nickfermilu/Mind-Masters/README.md

# Mind-Masters
ECE 455 Capstone Project - Brain Stimulator
