nickfermilu/Mind-Masters/SP26_Mind-Masters_Feedback_Circuit_Diagram_Braxton_Lang.png

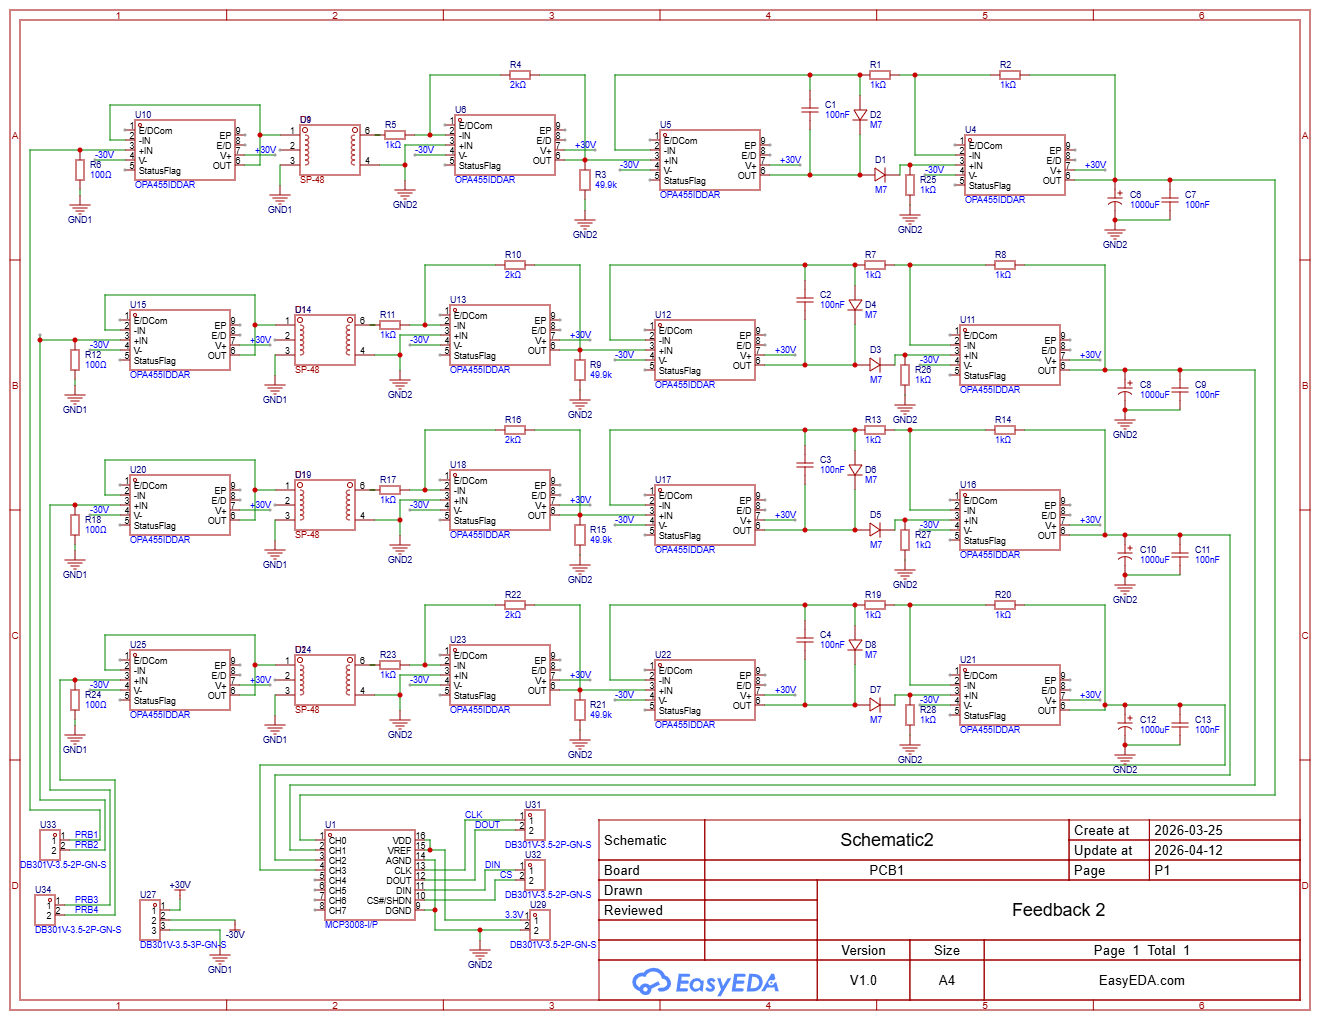
SP26_Mind-Masters_Feedback_Circuit_Diagram_Braxton_Lang.png
