nickfermilu/Mind-Masters/SP26_MindMasters_PowerBoardSchematic_NickLu.png

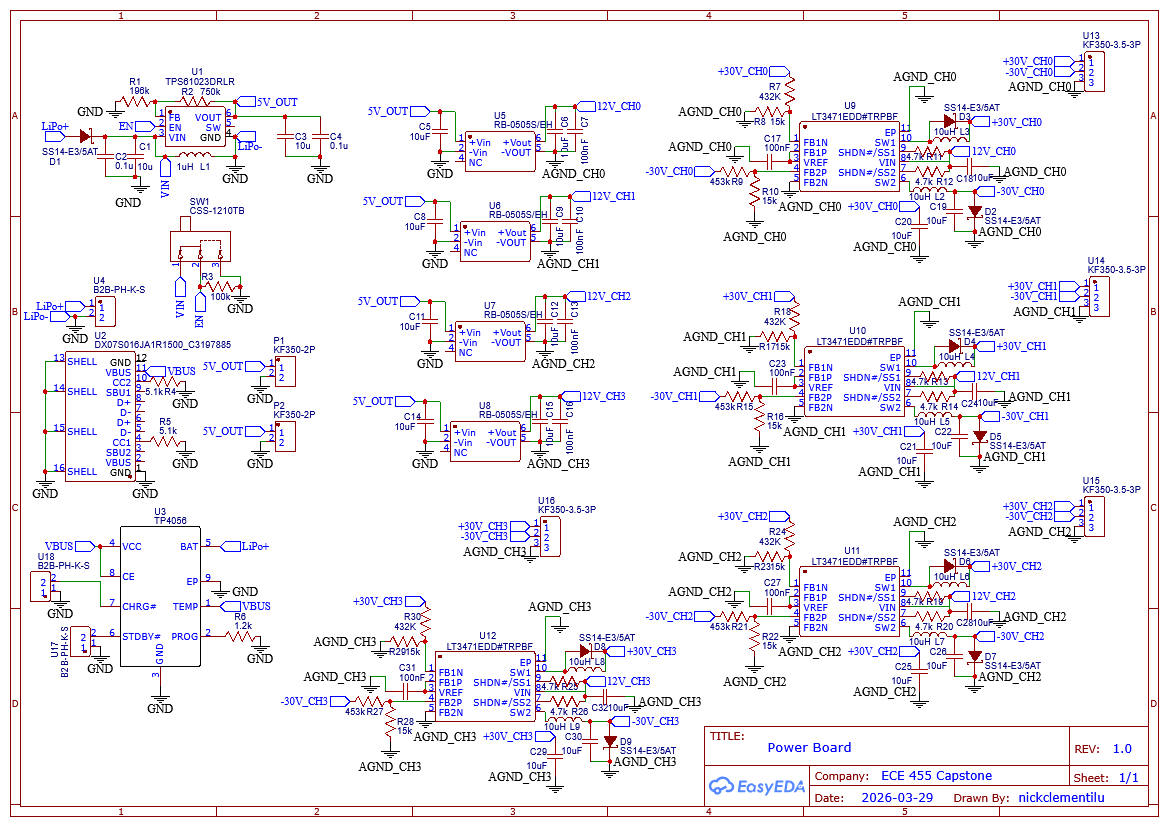
SP26_MindMasters_PowerBoardSchematic_NickLu.png
