nickfermilu/Mind-Masters/SP26_MindMasters_WaveformGenerationSchematic_NickLu.png

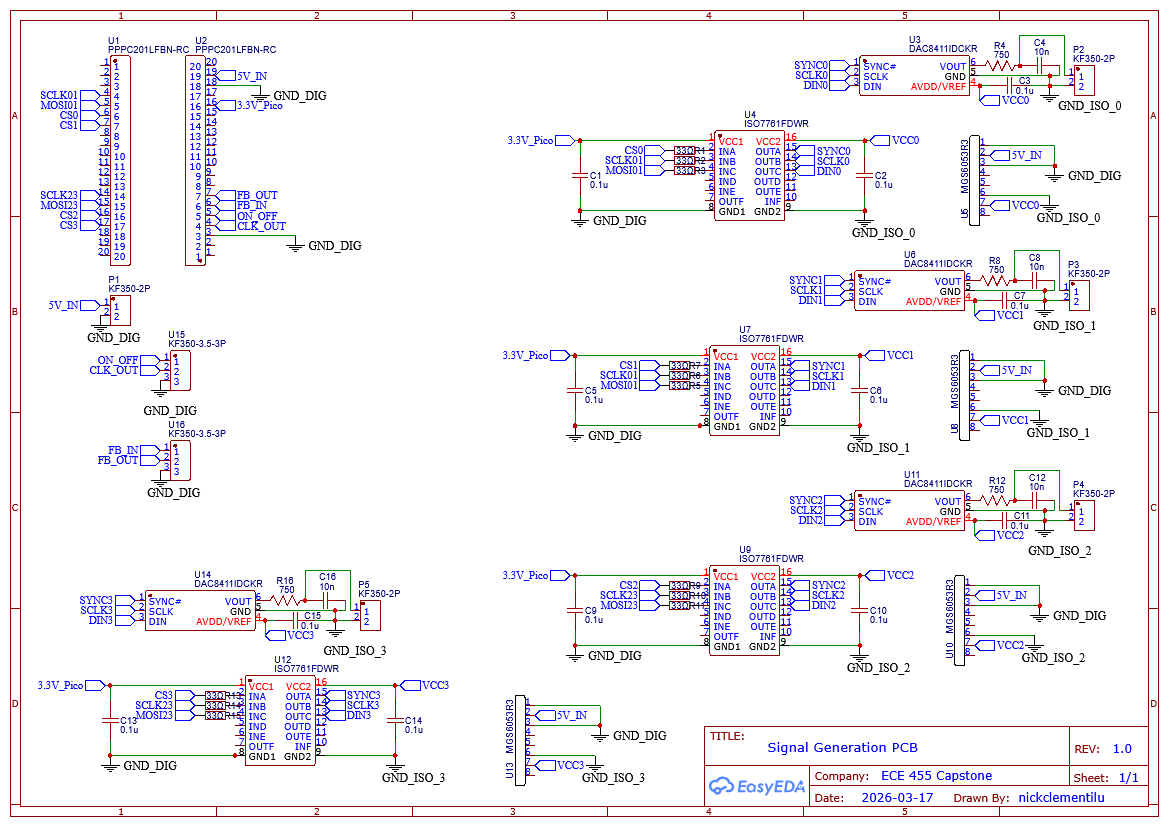
SP26_MindMasters_WaveformGenerationSchematic_NickLu.png
