nickfermilu/Mind-Masters/SP26_MindMasters_BillOfMaterials_NickLu.xlsx

Bill of Materials
Quantity | Description | Part | Category | Price | Total Spent | Link
20 | Screw In Terminal | 691137710002 | Current Amplifer | $0.38 | $6.96 | https://www.digikey.com/short/h4bqh1vj
10 | Resistor | RC1206DR-0710KL | Current Amplifer | $0.09 | $0.90 | https://www.digikey.com/short/cj3h99h8
10 | Resistor | RC1206FR-07634RL | Current Amplifer | $0.04 | $0.44 | https://www.digikey.com/short/8z23nzfm
10 | Resistor | RC1206FR-07100RL | Current Amplifer | $0.04 | $0.44 | https://www.digikey.com/short/29ft3q24
10 | Op Amp | OPA455IDDAR | Current Amplifer | $6.69 | $66.90 | https://www.digikey.com/short/r2zpp299
10 | Capacitor | CL05B104KB54PNC | Feedback | $0.39 | $0.39 | https://www.digikey.com/short/rv8q03bw
12 | Capacitor | CL10B104KB8NNNC | Feedback | $0.32 | $0.32 | https://www.digikey.com/short/pr99n85f
10 | Capacitor | CC0603KRX7R9BB103 | Feedback | $0.30 | $0.30 | https://www.digikey.com/short/327jvn84
10 | Resistor | RC0603FR-07750RL | Feedback | $0.24 | $0.24 | https://www.digikey.com/short/bptq3j8d
12 | Resistor | RC0603FR-0733RL | Feedback | $0.29 | $0.29 | https://www.digikey.com/short/p08cz4nz
4 | Capacitor | 10ZLH1000MEFC10X12.5 | Feedback | $0.51 | $2.04 | https://www.digikey.com/short/h4jvq459
16 | Resistor | RC0603FR-071KL | Feedback | $0.02 | $0.38 | https://www.digikey.com/short/2t2rhvq0
10 | Resistor | RC0603FR-0749K9L | Feedback | $0.02 | $0.24 | https://www.digikey.com/short/zh0wmth2
10 | Resistor | RC0603FR-072KL | Feedback | $0.02 | $0.24 | https://www.digikey.com/short/0hfjwmf7
10 | Resistor | RC0603FR-07100RL | Feedback | $0.02 | $0.24 | https://www.digikey.com/short/vdrw7z0f
1 | MCP | MCP3008-I/P | Feedback | $3.12 | $3.12 | https://www.digikey.com/short/5fw15d1m
16 | Op Amp | OPA455IDDAR | Feedback | $6.69 | $107.04 | https://www.digikey.com/short/pt8tj7qb
10 | Diode | M7 | Feedback | $0.07 | $0.72 | https://www.digikey.com/short/tjcvm2fp
4 | Transformer | SP-48 | Feedback | $17.75 | $71.00 | https://www.digikey.com/short/dvr8h1q8
8 | EEG Connector | 65.3300-21 | Output | $2.83 | $22.64 | https://www.tme.com/us/en-us/details/mlb1.5-r-21/2mm-banana-sockets/staubli/65-3300-21/
10 | EEG Electrode | MDYN-D48-10 | Output | $9.28 | $9.28 | https://www.saveritemedical.com/products/med-dyne-eeg-disposable-cup-electrodes?variant=40245685452886
10 | Screw In Terminal | 691214110002 | Power Generation | $1.04 | $10.36 | https://www.digikey.com/short/fdq5tqt4
4 | Screw In Terminal | 691214110003 | Power Generation | $0.62 | $6.19 | https://www.digikey.com/short/rp48hdb9
25 | Capacitor | CL21A106KAYNNNE | Power Generation | $0.10 | $2.45 | https://www.digikey.com/short/251p0d54
10 | Capacitor | CC0603KRX7R9BB104 | Power Generation | $0.04 | $0.43 | https://www.digikey.com/short/34rbfjpc
10 | Diode | SS14-E3/5AT | Power Generation | $0.18 | $1.84 | https://www.digikey.com/short/t3vn2f79
1 | Inductor | BRL3225T1R0M | Power Generation | $0.18 | $0.18 | https://www.digikey.com/short/2wmhvmqd
10 | Inductor | NRS5030T100MMGJ | Power Generation | $0.20 | $1.98 | https://www.digikey.com/short/0phn0vdz
1 | Switch | CSS-1210TB | Power Generation | $0.72 | $0.72 | https://www.digikey.com/short/jr14t4dr
1 | Charging IC | TPS61023DRLR | Power Generation | $1.12 | $1.12 | https://www.digikey.com/short/27f8v5zn
1 | USB-C Conn | DX07S016JA1R1500 | Power Generation | $2.15 | $2.15 | https://www.digikey.com/short/fj1hj9jr
3 | Header | B2B-PH-K-S | Power Generation | $0.11 | $0.33 | https://www.digikey.com/short/7hq5d353
4 | Boost Converter | LT3471EDD#TRPBF | Power Generation | $9.79 | $39.16 | https://www.digikey.com/short/www0zcv7
4 | DC DC Converter | RB-0505S | Power Generation | $6.51 | $26.04 | https://www.digikey.com/short/h7d9pmt0
1 | Charging IC | TPB4056B2X-ES1R | Power Generation | $0.50 | $0.50 | https://www.digikey.com/short/qqh5pww2
2 | Capacitor | CC0603MRX5R6BB106 | Power Generation | $0.18 | $0.36 | https://www.digikey.com/short/t2r2m115
10 | Resistor | RC0603FR-071K2L | Power Generation | $0.02 | $0.24 | https://www.digikey.com/short/8t29rbhq
10 | Resistor | RC0603FR-074K7L | Power Generation | $0.02 | $0.24 | https://www.digikey.com/short/h5t0njh5
10 | Resistor | RC0603FR-075K1L | Power Generation | $0.02 | $0.24 | https://www.digikey.com/short/c2mvb1rh
10 | Resistor | RC0603FR-0715KL | Power Generation | $0.02 | $0.24 | https://www.digikey.com/short/284tnr3t
10 | Resistor | RC0603FR-07100KL | Power Generation | $0.02 | $0.24 | https://www.digikey.com/short/qzfd5wp3
10 | Resistor | RC0603FR-07196KL | Power Generation | $0.02 | $0.24 | https://www.digikey.com/short/h9zn8245
10 | Resistor | RC0603FR-07453KL | Power Generation | $0.02 | $0.24 | https://www.digikey.com/short/5zpdhcjz
10 | Resistor | RC0603FR-07432KL | Power Generation | $0.02 | $0.24 | https://www.digikey.com/short/715fbr88
10 | Resistor | RC0603FR-07750KL | Power Generation | $0.02 | $0.24 | https://www.digikey.com/short/72mpm7fc
1 | Battery | 3.7V 2300mAh 104050 Lipo Battery | Power Generation | $10.99 | $10.99 | https://www.amazon.com/dp/B0GDQG1PXW
1 | LEDs | Panel Mount LED | Power Generation | $13.99 | $13.99 | https://www.amazon.com/dp/B0B2L89W9C
1 | Switch | SS12F15 Slide Switch | Power Generation | $4.99 | $4.99 | https://www.amazon.com/dp/B0FNRDWD4B
4 | DAC | DAC8411IDCKT | Signal Generation | $8.08 | $32.32 | https://www.digikey.com/short/pbwnvqr3
4 | SPI Isolation | ISO7761FDWR | Signal Generation | $3.67 | $14.68 | https://www.digikey.com/short/qnvhtwzt
4 | LDO Regulator | MCP1700-3302E/TO | Signal Generation | $0.50 | $2.00 | https://www.digikey.com/short/jbv518jv
1 | LDO Regulator | MCP1700-3302E/TO | Signal Generation | $0.50 | $0.50 | https://www.digikey.com/short/jbv518jv
4 | DC DC Converter | MGS6053R3 | Signal Generation | $20.71 | $82.84 | https://www.digikey.com/short/tj5ddddw
2 | Header | PPPC201LFBN-RC | Signal Generation | $1.14 | $2.28 | https://www.digikey.com/short/hfb5n4v4
2 | Screw In Terminal | 691214110003 | Signal Generation | $1.55 | $3.10 | https://www.digikey.com/short/wrd3p9hp
10 | Screw In Terminal | 691214110002 | Signal Generation | $1.04 | $10.36 | https://www.digikey.com/short/8d859f7f
