nickfermilu/Mind-Masters/(list of files, cad)

Other CAD files:
SP26_MindMasters_Enclosure_CameronVanOs.f3d
