nickfermilu/Mind-Masters/SP26_Mind_Masters_Feedback_PCB_Braxton_Lang.pdf

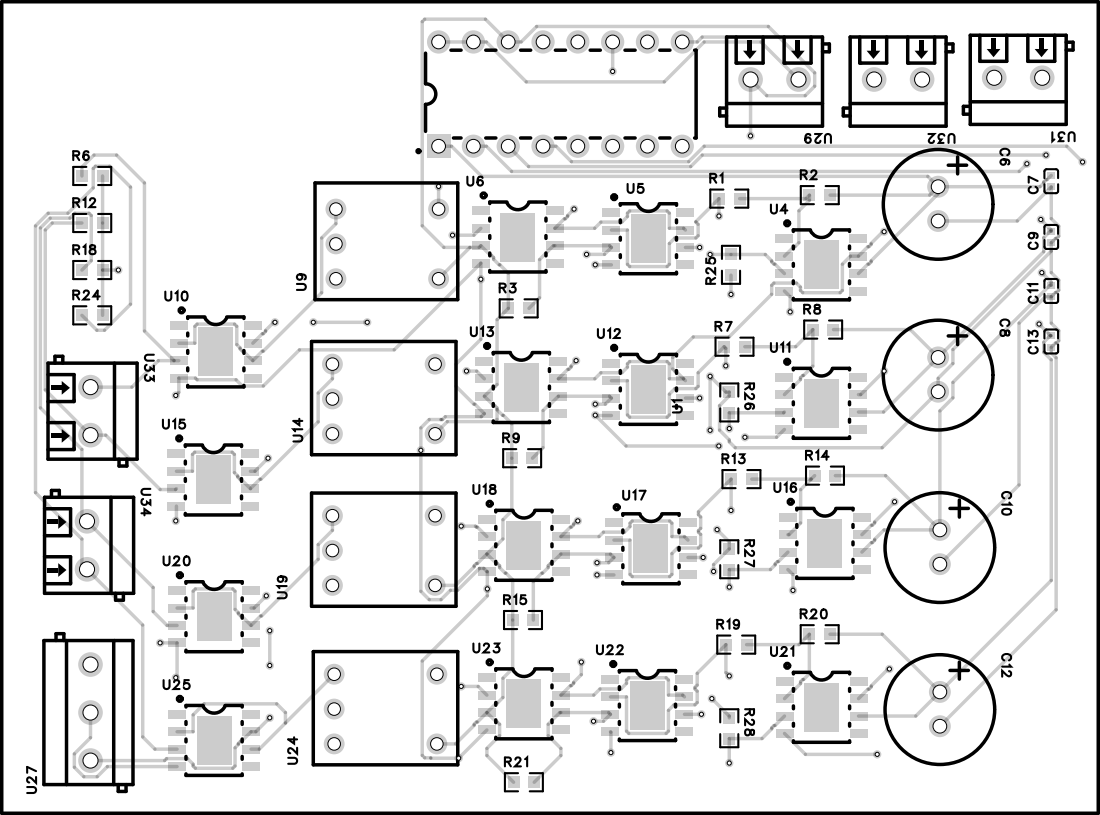
[picture p4: page 1]

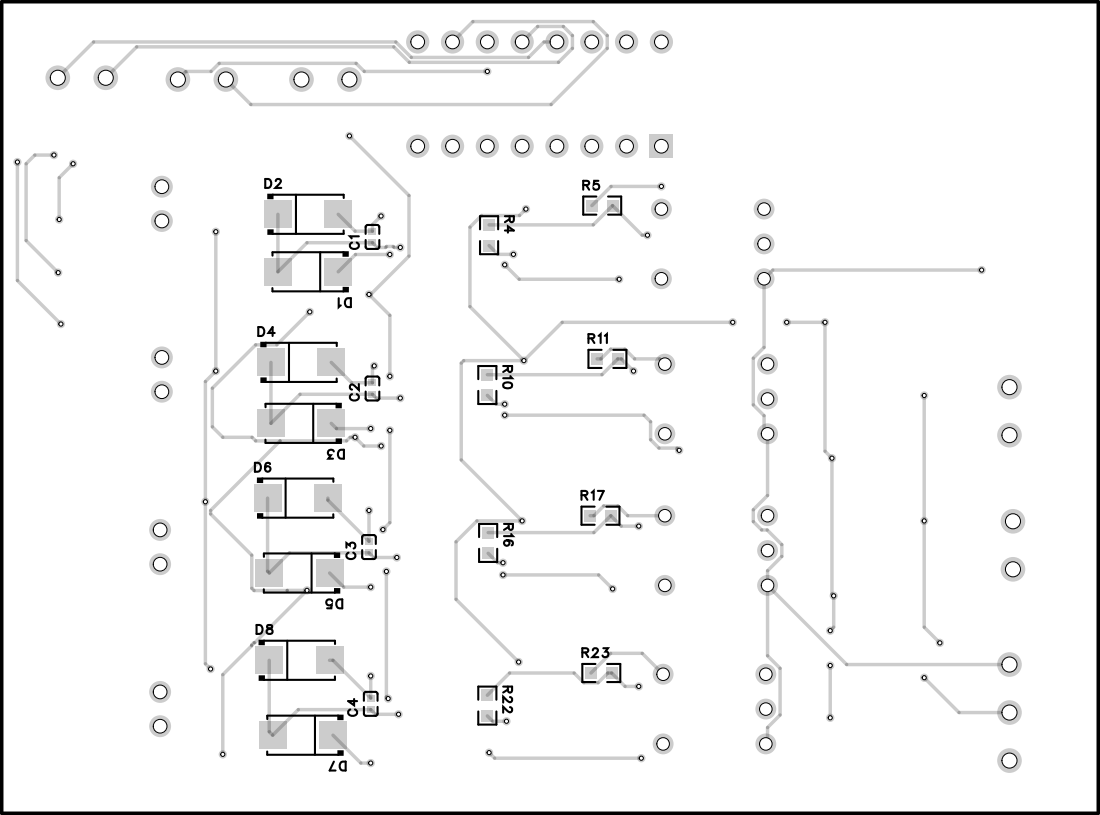
[picture p5: page 2]

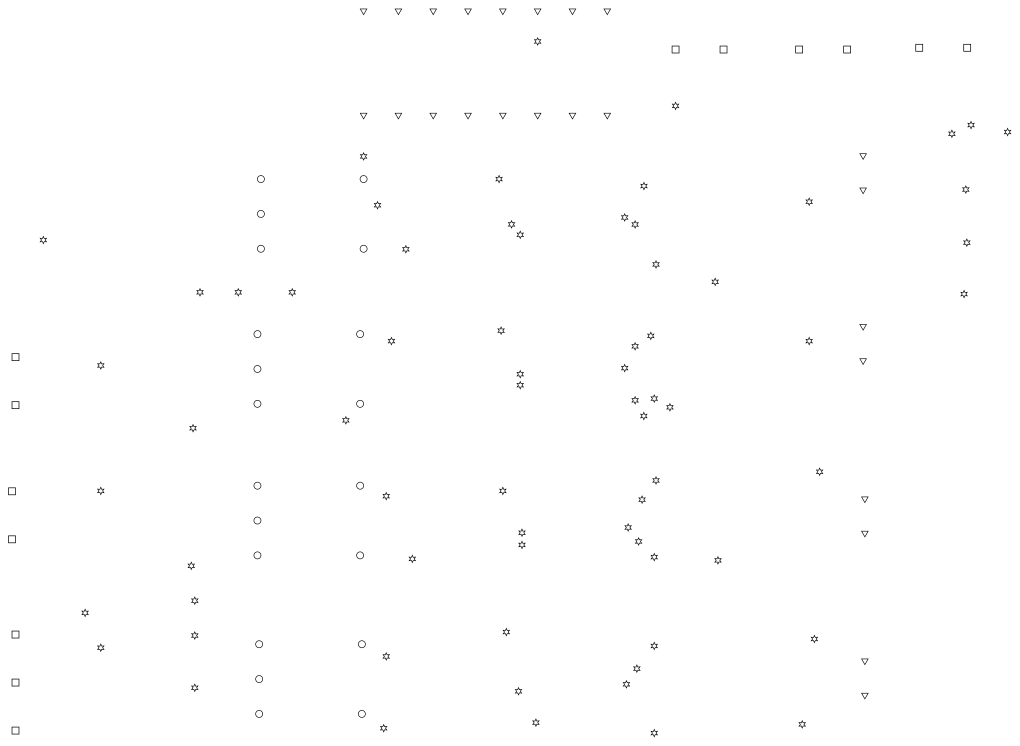
[picture p6: page 3]
