nickfermilu/Mind-Masters/SP26_MindMasters_PowerBoardPCB_NickLu.pdf

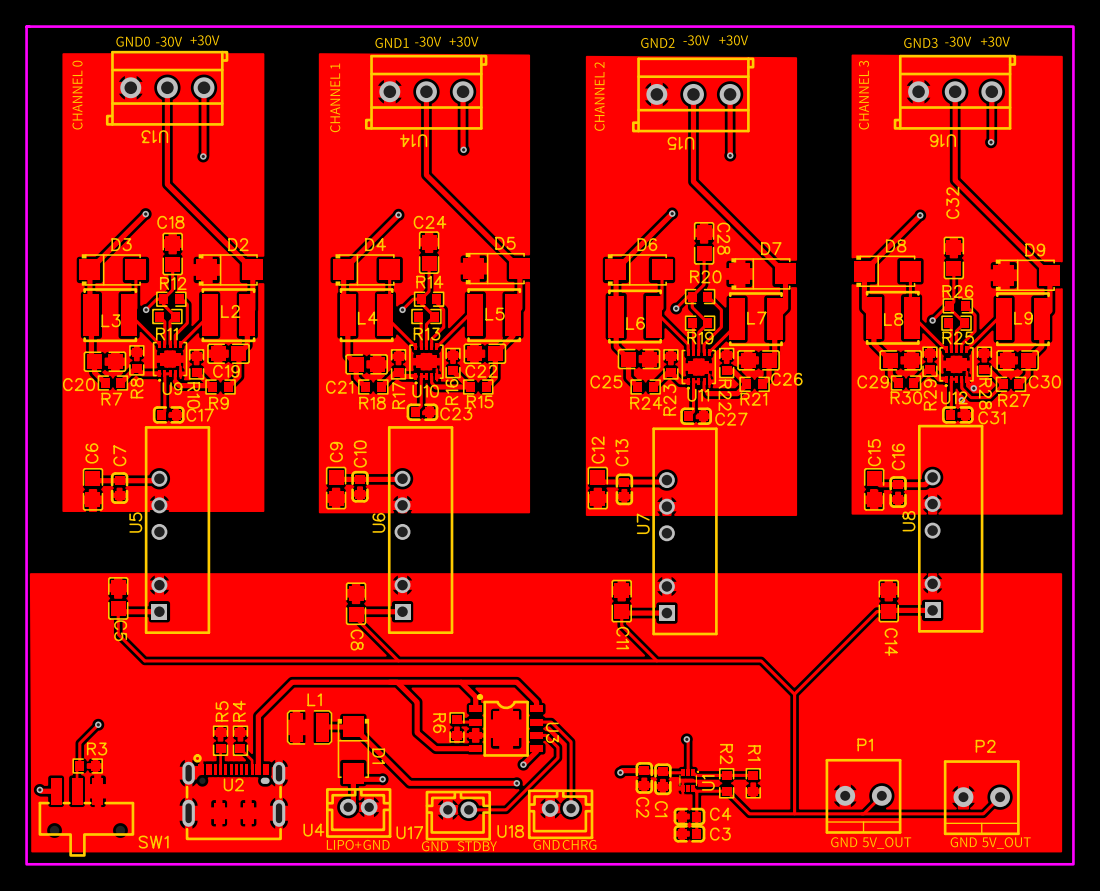
[picture p7: page 1]
