nickfermilu/Mind-Masters/SP26_MindMasters_WaveformGenerationPCB_NickLu.pdf

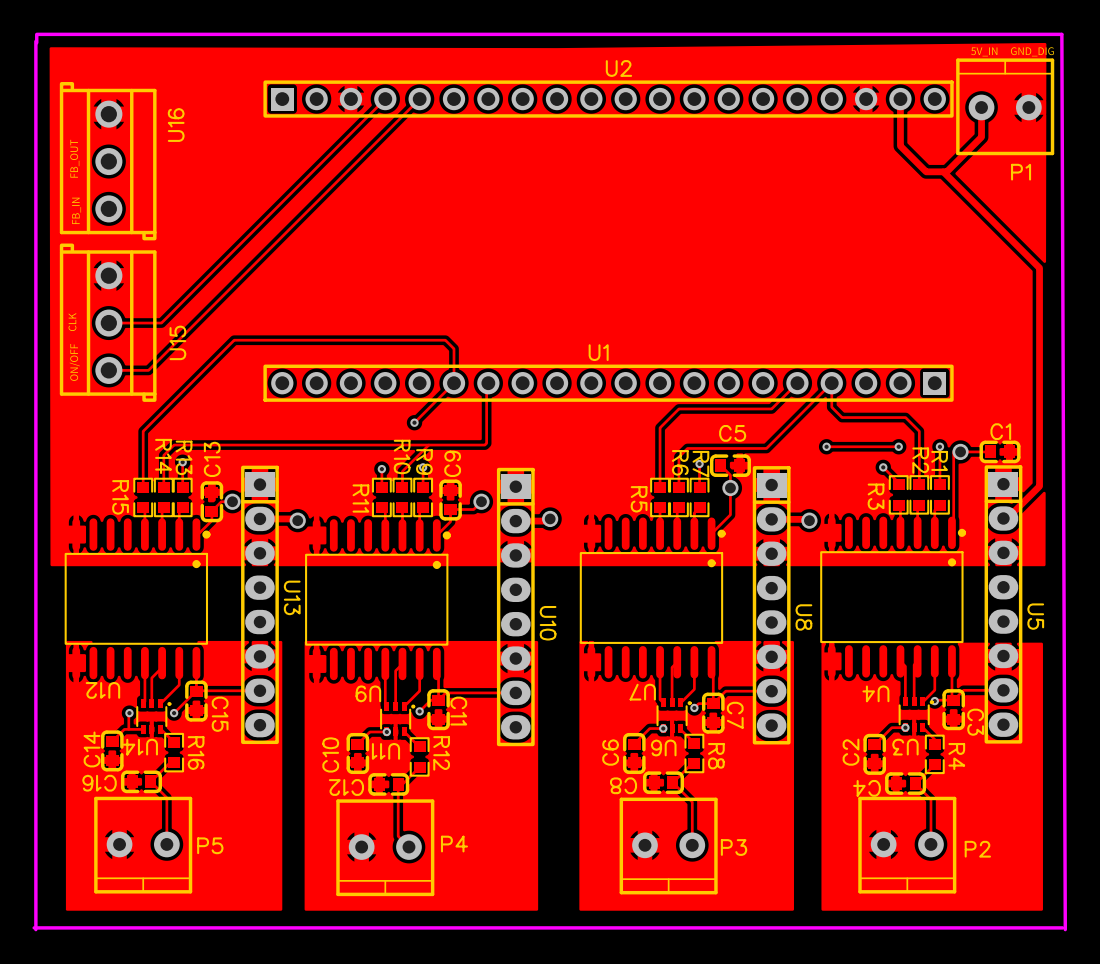
[picture p8: page 1]
