nickfermilu/Mind-Masters/SP26_MindMasters_FeedbackSimulation_BraxtonLang.asc

C1: cap; 47pF
C2: cap; 1000µF
D1: diode
D2: diode
I1: current; SINE(0 2mA 0.5k)
L1: ind2; 1
L2: ind2; 22
R1: res; 49.9k
R2: res; 1k
R3: res; 1k
R4: res; 1k
R5: res; 100
R6: res; 2k
R7: res; 1k
U1: OP07
U2: OP07
U3: OP07
U4: OP07
V2: voltage; 15V
V3: voltage; -15V
Named nets: 0, +15V, -15V
.tran 0 1 0 10
K1 L1 L2 1
