nickfermilu/Mind-Masters/SP26_MindMasters_Pico2WCode_NickLu/brain_stimulator.c

#include <stdio.h>
#include "pico/stdlib.h"
#include "hardware/spi.h"
#include "hardware/dma.h"
#include "hardware/pio.h"
#include "hardware/timer.h"

// SPI Defines
// We are going to use SPI 0, and allocate it to the following GPIO pins
// Pins can be changed, see the GPIO function select table in the datasheet for information on GPIO assignments
#define SPI_PORT spi0
#define PIN_MISO 16
#define PIN_CS   17
#define PIN_SCK  18
#define PIN_MOSI 19

// Data will be copied from src to dst
const char src[] = "Hello, world! (from DMA)";
char dst[count_of(src)];

#include "blink.pio.h"

void blink_pin_forever(PIO pio, uint sm, uint offset, uint pin, uint freq) {
    blink_program_init(pio, sm, offset, pin);
    pio_sm_set_enabled(pio, sm, true);

    printf("Blinking pin %d at %d Hz\n", pin, freq);

    // PIO counter program takes 3 more cycles in total than we pass as
    // input (wait for n + 1; mov; jmp)
    pio->txf[sm] = (125000000 / (2 * freq)) - 3;
}

int64_t alarm_callback(alarm_id_t id, void *user_data) {
    // Put your timeout handler code in here
    return 0;
}



int main()
{
    stdio_init_all();

    // SPI initialisation. This example will use SPI at 1MHz.
    spi_init(SPI_PORT, 1000*1000);
    gpio_set_function(PIN_MISO, GPIO_FUNC_SPI);
    gpio_set_function(PIN_CS,   GPIO_FUNC_SIO);
    gpio_set_function(PIN_SCK,  GPIO_FUNC_SPI);
    gpio_set_function(PIN_MOSI, GPIO_FUNC_SPI);
    
    // Chip select is active-low, so we'll initialise it to a driven-high state
    gpio_set_dir(PIN_CS, GPIO_OUT);
    gpio_put(PIN_CS, 1);
    // For more examples of SPI use see https://github.com/raspberrypi/pico-examples/tree/master/spi

    // Get a free channel, panic() if there are none
    int chan = dma_claim_unused_channel(true);
    
    // 8 bit transfers. Both read and write address increment after each
    // transfer (each pointing to a location in src or dst respectively).
    // No DREQ is selected, so the DMA transfers as fast as it can.
    
    dma_channel_config c = dma_channel_get_default_config(chan);
    channel_config_set_transfer_data_size(&c, DMA_SIZE_8);
    channel_config_set_read_increment(&c, true);
    channel_config_set_write_increment(&c, true);
    
    dma_channel_configure(
        chan,          // Channel to be configured
        &c,            // The configuration we just created
        dst,           // The initial write address
        src,           // The initial read address
        count_of(src), // Number of transfers; in this case each is 1 byte.
        true           // Start immediately.
    );
    
    // We could choose to go and do something else whilst the DMA is doing its
    // thing. In this case the processor has nothing else to do, so we just
    // wait for the DMA to finish.
    dma_channel_wait_for_finish_blocking(chan);
    
    // The DMA has now copied our text from the transmit buffer (src) to the
    // receive buffer (dst), so we can print it out from there.
    puts(dst);

    // PIO Blinking example
    PIO pio = pio0;
    uint offset = pio_add_program(pio, &blink_program);
    printf("Loaded program at %d\n", offset);
    
    #ifdef PICO_DEFAULT_LED_PIN
    blink_pin_forever(pio, 0, offset, PICO_DEFAULT_LED_PIN, 3);
    #else
    blink_pin_forever(pio, 0, offset, 6, 3);
    #endif
    // For more pio examples see https://github.com/raspberrypi/pico-examples/tree/master/pio

    // Timer example code - This example fires off the callback after 2000ms
    add_alarm_in_ms(2000, alarm_callback, NULL, false);
    // For more examples of timer use see https://github.com/raspberrypi/pico-examples/tree/master/timer

    while (true) {
        printf("Hello, world!\n");
        sleep_ms(1000);
    }
}
