nickfermilu/Mind-Masters/SP26_MindMasters_Pico2WCode_NickLu/btstack_config.h

#ifndef BTSTACK_CONFIG_H
#define BTSTACK_CONFIG_H

// BLE Peripheral mode (ENABLE_BLE is set by pico_btstack_ble in CMake)
#define ENABLE_LE_PERIPHERAL

// Logging (comment out for production)
#define ENABLE_LOG_INFO
#define ENABLE_LOG_ERROR
#define ENABLE_PRINTF_HEXDUMP

// Security
#define ENABLE_SOFTWARE_AES128
#define ENABLE_MICRO_ECC_FOR_LE_SECURE_CONNECTIONS

// Buffer / resource sizing
#define HCI_OUTGOING_PRE_BUFFER_SIZE    4
#define HCI_ACL_PAYLOAD_SIZE            (255 + 4)
#define HCI_ACL_CHUNK_SIZE_ALIGNMENT    4
#define MAX_NR_GATT_CLIENTS             0
#define MAX_NR_HCI_CONNECTIONS          1
#define MAX_NR_L2CAP_CHANNELS           4
#define MAX_NR_L2CAP_SERVICES           3
#define MAX_NR_SM_LOOKUP_ENTRIES        3
#define MAX_NR_WHITELIST_ENTRIES        16
#define MAX_NR_LE_DEVICE_DB_ENTRIES     16
#define MAX_ATT_DB_SIZE                 512

// CYW43 flow control (critical for Pico W shared SPI bus)
#define MAX_NR_CONTROLLER_ACL_BUFFERS   3
#define MAX_NR_CONTROLLER_SCO_PACKETS   3
#define ENABLE_HCI_CONTROLLER_TO_HOST_FLOW_CONTROL
#define HCI_HOST_ACL_PACKET_LEN         (255 + 4)
#define HCI_HOST_ACL_PACKET_NUM         3
#define HCI_HOST_SCO_PACKET_LEN         120
#define HCI_HOST_SCO_PACKET_NUM         3

// Flash persistence
#define NVM_NUM_DEVICE_DB_ENTRIES       16
#define NVM_NUM_LINK_KEYS               16

// Platform
#define HAVE_EMBEDDED_TIME_MS
#define HAVE_ASSERT
#define HCI_RESET_RESEND_TIMEOUT_MS     1000

#endif // BTSTACK_CONFIG_H
