nickfermilu/Mind-Masters/(commit log)

2026-05-05 Create Pico folder
2026-05-05 Added Bill of Materials
    [SP26_MindMasters_BillOfMaterials_NickLu.xlsx]
2026-05-05 Added Cameron's contribution
    [SP26_MindMasters_Enclosure_CameronVanOs.f3d]
